Ovidijus-Sobutas/stepper-music/esp and mega wiring.png

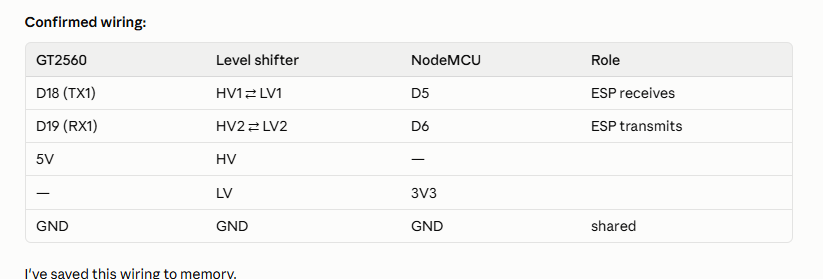
esp and mega wiring.png
