Ovidijus-Sobutas/stepper-music/oled wiring.png

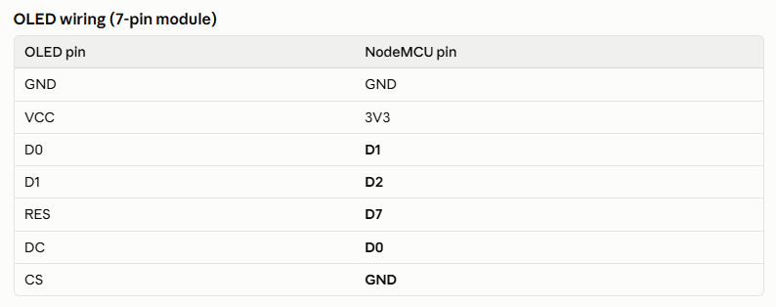
oled wiring.png
