Ovidijus-Sobutas/stepper-music/(commit log)

2026-10-07 Add MIT license and project README
    MIT license and the project README (what it is, hardware, wiring,
    build and flash steps, first-time setup, tools). The code follows
    in later commits.
2026-10-08 Add GT2560 firmware
    ATmega2560 engine that drives the 5 stepper motors: framed serial link
    to the ESP8266 (CRC, retries, duplicate-reply cache, heartbeat timeout),
    note buffer and song clock, timer-driven step generation with
    continuous rotation, step budget and motor release.
2026-10-08 Add web page
    The page the player serves: now playing and queue, songs with search,
    playlists, sound styles, motor test, Wi-Fi and settings, and the MIDI
    to .stepper converter that runs in the browser. Timings and choices
    live in settings.js; WebAssets.h is the packed copy built by
    tools/build_web.ps1.
2026-10-08 Add build and test tools
    PowerShell helpers: firmware preparation from .env, web page packing,
    demo song conversion, serial monitor and console, local test server,
    converter test, and hardware tests for the link, web API, song
    library, sound styles and stress.
2026-10-08 Add project plan and wiring pictures, update README
    docs/PLAN.md: wiring, protocol, progress and lessons. README: local
    settings (.env), demo songs, finding the player on the network.
